ihsan-sa/ece298a-r2r-dac/README.md

# r2r-dac

A project of the ece298a workspace, and the only project in this repository.
Its work is the `track/r2r-dac` branch.
