ihsan-sa/ece298a-r2r-dac/.dispatch/notes/3.md

# Dispatch notes, issue #3

## 2026-10-14 run 1

- Did: Sized the gap for "Bring main up to the DAC's current state". 8,324 files under `blocks/r2r_dac` differ between main and `track/r2r-dac` (`dff4609`), and 710 are left once flow scratch is out (`state_snapshots/`, `__pycache__/`, and the numbered step dirs and `tmp/` under `harden/runs/run/`). Wrote that scratch list, a runnable Done-when command and the blocker into GOALS.md, and added a Pull requests line to both open goals.
- Decided: Keep `harden/runs/run/final/` even though it sits under a run directory. The tile's signed-off GDS, LEF and netlist exist only there. Didn't move a Later goal up, because no proposed goal closed.
- Learned: A run can't make the sync commit. `git rm` and `git checkout <ref> -- <path>` are refused (only `bash tests/check.sh`, `git add -A` and `git commit` are allowed), and Edit/Write can't carry GDS binaries. `git diff`, `git show` and `git grep` against `origin/track/r2r-dac` do work for reading.
- Needs: The owner (or a run allowed `git checkout`/`git rm`) has to make the sync commit using the recipe in GOALS.md. Until then, runs work from main's stale design. GOALS.md has no `## Standing goals` section, so new goals can't name the goal they serve as the brief asks. The owner should add one.
- Friction: About a third of this run went to finding out that the sync step can't be done with the allowed commands. The brief also assumes a Standing goals section and a Serves line, and GOALS.md has neither. `bash tests/check.sh` exits 2 on this worker because iverilog isn't on PATH, so no run here can pass the check locally. This PR changes only Markdown, so it leaves CI's check unaffected.
- Wake: Once `track/r2r-dac` lands on main, run the Done-when command, close the goal, and move "Make the repository build as a Tiny Tapeout analog project" up from Later.
