ihsan-sa/ece298a-r2r-dac/.dispatch/notes/15.md

# Dispatch notes, issue #15

## 2026-10-14 run 1

- Did: Took the next step on the only open goal, the Tiny Tapeout project. Drafted the root `info.yaml` (template yaml_version 6 layout, pinout from `spec.yaml`'s `tt_pins`, top/tiles/analog_pins from the hardened tile) and `docs/info.md` (how it works, how to test, external hardware, from `docs/design.md`) under `tt_project/`, with a README listing the `git mv`/`cp` commands that land the whole project in one commit. Updated the goal's blocker and Pull requests lines and added #13 to the Closed PR list.
- Decided: Staged under `tt_project/` so the root check keeps skipping. Didn't draft `src/*.v`: they are verbatim copies of the hardened top, `top/rtl/r2r_dac_digital.v` and the analog stub, and hand-retyping them would risk drift from what was hardened. Left `author` blank rather than guess the owner's name. Set `uses_3v3: true` and `yaml_version: 6` from memory of the template, flagged in the file for the owner to check.
- Learned: The output source resistance is the unit R, 27 kΩ, so `docs/info.md` asks for a light load; the flow's own `precheck_run/info.yaml` is only the five-line minimal form, not the template's.
- Needs: The owner runs the commands in `tt_project/README.md`, fills `author`, adds the template's gds/docs workflows, and checks the field names against the template. Nothing more a run can do on this goal until then.
- Friction: `bash tests/check.sh` exits 2 (no iverilog on PATH, fifth run in a row); this PR is YAML and Markdown only, outside what the check reads. GOALS.md still has no `## Standing goals` section.
- Wake: When a root `info.yaml` lands, to run `python3 tests/check_tt_project.py` and close the goal; until then later runs should make no commit unless a new goal is worth filing.
