ihsan-sa/ece298a-r2r-dac/blocks/r2r_dac/log/P0-digest.md

# P0 digest
- block r2r_dac, skill msde, brief/spec.md copied from the board row.
- Known pipeline gap before starting: no TT analog tile (ua[] pins) in chip-flow; top gates expected to refuse.
