ihsan-sa/ece298a-r2r-dac/blocks/r2r_dac/top/harden/runs/run/final/render/tt_um_r2r_dac_digital.png

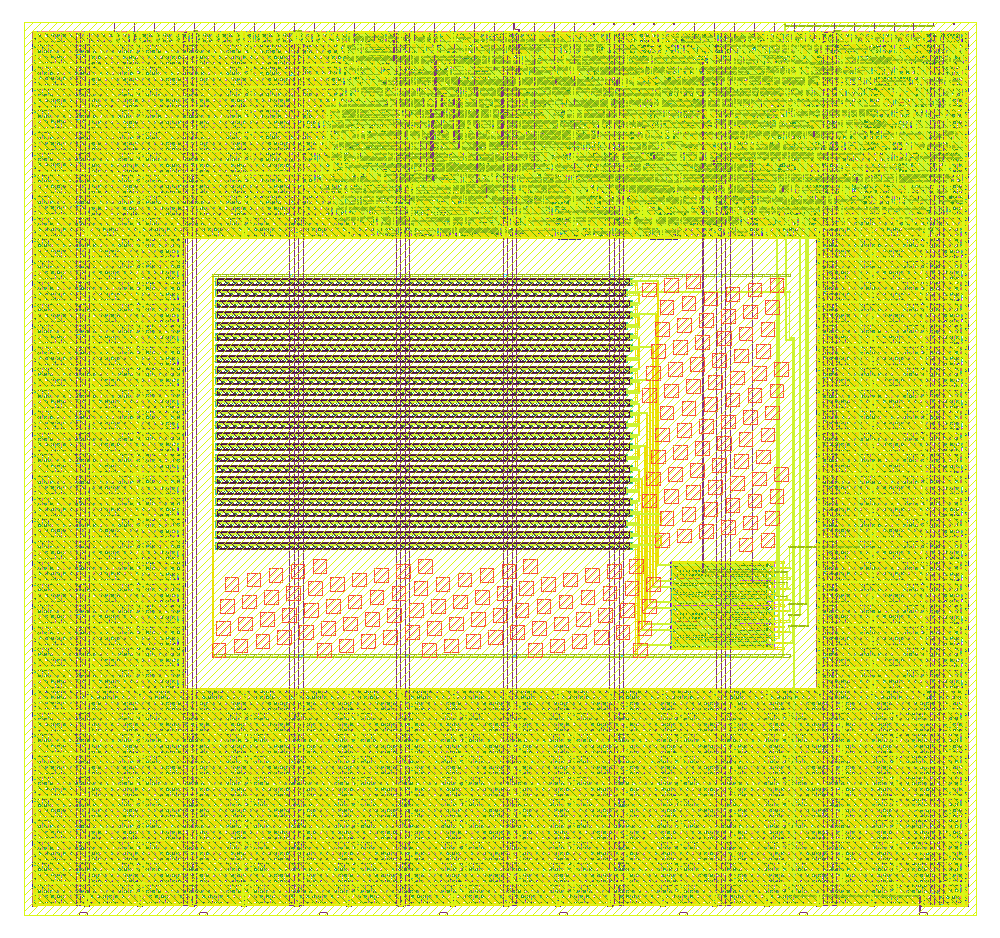
blocks/r2r_dac/top/harden/runs/run/final/render/tt_um_r2r_dac_digital.png
