ihsan-sa/ece298a-r2r-dac/blocks/r2r_dac/digital/log/precheck_run/design/tt_um_r2r_dac_digital.v

module tt_um_r2r_dac_digital (clk,
    ena,
    rst_n,
    VPWR,
    VGND,
    ui_in,
    uio_in,
    uio_oe,
    uio_out,
    uo_out);
 input clk;
 input ena;
 input rst_n;
 inout VPWR;
 inout VGND;
 input [7:0] ui_in;
 input [7:0] uio_in;
 output [7:0] uio_oe;
 output [7:0] uio_out;
 output [7:0] uo_out;

 wire _000_;
 wire _001_;
 wire _002_;
 wire _003_;
 wire _004_;
 wire _005_;
 wire _006_;
 wire _007_;
 wire _008_;
 wire _009_;
 wire _010_;
 wire _011_;
 wire _012_;
 wire _013_;
 wire _014_;
 wire _015_;
 wire _016_;
 wire _017_;
 wire _018_;
 wire _019_;
 wire _020_;
 wire _021_;
 wire _022_;
 wire _023_;
 wire _024_;
 wire _025_;
 wire _026_;
 wire _027_;
 wire _028_;
 wire _029_;
 wire _030_;
 wire _031_;
 wire _032_;
 wire _033_;
 wire _034_;
 wire _035_;
 wire _036_;
 wire _037_;
 wire _038_;
 wire _039_;
 wire _040_;
 wire _041_;
 wire _042_;
 wire _043_;
 wire _044_;
 wire _045_;
 wire _046_;
 wire _047_;
 wire _048_;
 wire _049_;
 wire _050_;
 wire _051_;
 wire _052_;
 wire _053_;
 wire _054_;
 wire _055_;
 wire _056_;
 wire _057_;
 wire _058_;
 wire _059_;
 wire _060_;
 wire _061_;
 wire _062_;
 wire _063_;
 wire _064_;
 wire _065_;
 wire _066_;
 wire _067_;
 wire _068_;
 wire _069_;
 wire _070_;
 wire _071_;
 wire _072_;
 wire _073_;
 wire _074_;
 wire _075_;
 wire _076_;
 wire _077_;
 wire _078_;
 wire _079_;
 wire _080_;
 wire _081_;
 wire _082_;
 wire _083_;
 wire _084_;
 wire _085_;
 wire _086_;
 wire _087_;
 wire _088_;
 wire _089_;
 wire _090_;
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
    .VNW(VPWR),
    .VPW(VGND),
    .VSS(VGND));
 gf180mcu_fd_sc_mcu7t5v0__fillcap_4 FILLER_8_591 (.VDD(VPWR),
    .VNW(VPWR),
    .VPW(VGND),
    .VSS(VGND));
 gf180mcu_fd_sc_mcu7t5v0__fillcap_8 FILLER_8_597 (.VDD(VPWR),
    .VNW(VPWR),
    .VPW(VGND),
    .VSS(VGND));
 gf180mcu_fd_sc_mcu7t5v0__fillcap_4 FILLER_9_136 (.VDD(VPWR),
    .VNW(VPWR),
    .VPW(VGND),
    .VSS(VGND));
 gf180mcu_fd_sc_mcu7t5v0__fillcap_64 FILLER_9_142 (.VDD(VPWR),
    .VNW(VPWR),
    .VPW(VGND),
    .VSS(VGND));
 gf180mcu_fd_sc_mcu7t5v0__fillcap_64 FILLER_9_2 (.VDD(VPWR),
    .VNW(VPWR),
    .VPW(VGND),
    .VSS(VGND));
 gf180mcu_fd_sc_mcu7t5v0__fillcap_4 FILLER_9_206 (.VDD(VPWR),
    .VNW(VPWR),
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
