ihsan-sa/ece298a-r2r-dac/blocks/r2r_dac/digital/log/formal/cov/src/r2r_dac_digital.v

`default_nettype none
// r2r_dac_digital - digital front end of the 8-bit R-2R DAC.
// mode 00 register (capture ui_in), 01 ramp, 10 sine, 11 hold. dac_code registered.
module r2r_dac_digital (
    input  wire       clk,
    input  wire       rst_n,
    input  wire       ena,
    input  wire [7:0] ui_in,
    input  wire [1:0] mode,
    input  wire       slow,
    output reg  [7:0] dac_code,
    output wire [7:0] uo_out
);
  reg [7:0] code_reg;
  reg [7:0] cnt;
  reg [7:0] presc;
  reg [7:0] sine_val;

  wire unused_ena = ena;

  always @(*) begin
    case (cnt)
      8'd0: sine_val = 8'd128;
      8'd1: sine_val = 8'd131;
      8'd2: sine_val = 8'd134;
      8'd3: sine_val = 8'd137;
      8'd4: sine_val = 8'd140;
      8'd5: sine_val = 8'd143;
      8'd6: sine_val = 8'd146;
      8'd7: sine_val = 8'd149;
      8'd8: sine_val = 8'd152;
      8'd9: sine_val = 8'd155;
      8'd10: sine_val = 8'd158;
      8'd11: sine_val = 8'd162;
      8'd12: sine_val = 8'd165;
      8'd13: sine_val = 8'd167;
      8'd14: sine_val = 8'd170;
      8'd15: sine_val = 8'd173;
      8'd16: sine_val = 8'd176;
      8'd17: sine_val = 8'd179;
      8'd18: sine_val = 8'd182;
      8'd19: sine_val = 8'd185;
      8'd20: sine_val = 8'd188;
      8'd21: sine_val = 8'd190;
      8'd22: sine_val = 8'd193;
      8'd23: sine_val = 8'd196;
      8'd24: sine_val = 8'd198;
      8'd25: sine_val = 8'd201;
      8'd26: sine_val = 8'd203;
      8'd27: sine_val = 8'd206;
      8'd28: sine_val = 8'd208;
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
      8'd250: sine_val = 8'd109;
      8'd251: sine_val = 8'd112;
      8'd252: sine_val = 8'd115;
      8'd253: sine_val = 8'd118;
      8'd254: sine_val = 8'd121;
      8'd255: sine_val = 8'd124;
      default: sine_val = 8'd128;
    endcase
  end

  wire step = ~slow | (presc == 8'hFF);

  always @(posedge clk) begin
    if (!rst_n) begin
      code_reg <= 8'd0;
      cnt      <= 8'd0;
      presc    <= 8'd0;
      dac_code <= 8'd0;
    end else begin
      case (mode)
        2'b00: dac_code <= ui_in;
        2'b01: dac_code <= cnt;
        2'b10: dac_code <= sine_val;
        default: dac_code <= code_reg;
      endcase
      if (mode == 2'b00)
        code_reg <= ui_in;
      presc <= presc + 8'd1;
      if (step)
        cnt <= cnt + 8'd1;
    end
  end

  assign uo_out = dac_code;
endmodule
`default_nettype wire
