ihsan-sa/ece298a-r2r-dac/(commit log)

2026-09-25 wip: checkpoint 2026-09-25T13:47:03Z [335 file(s)] [cc]
    [placement.cfg, tt_um_r2r_dac_digital__nom_ff_n40C_3v60.sdf, tt_um_r2r_dac_digital__nom_ss_125C_3v00.sdf, tt_um_r2r_dac_digital__nom_tt_025C_3v30.sdf]
2026-10-14 Bring main up to track/r2r-dac and record the owner's three sign-offs (#7)
    * Bring main up to the DAC's state on track/r2r-dac
    Carries blocks/r2r_dac from track/r2r-dac at dff4609, less the flow
    scratch GOALS.md names (state_snapshots, __pycache__, and the numbered
    step dirs and tmp/ under harden/runs/run). harden/runs/run/final, which
    holds the tile's signed-off GDS, LEF and netlist, stays.
    Claude-Session: https://claude.ai/code/session_016F17mH73JEGFZxqysBxHp4
    * Record the owner's three DAC sign-offs
    His reply, verbatim: "approve H2-1452e6 H2-4da295 H2-a7bfe1", top-level in
    #ece298a-dac-asks (slack C0C96C5EUTT/1791992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
2026-10-14 Stage Tiny Tapeout info.yaml and docs/info.md under tt_project/ (#16)
2026-10-14 check.sh runs iverilog through chip-flow's eda when it isn't on PATH (#14)
    Claude-Session: https://claude.ai/code/session_012Te5n3RsLrG27y71cTY1uH
2026-10-14 GOALS.md names the chip-flow commands an engine run may use
    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
